marcelocesarreis/safeboat-termica/stl/tampa-traseira.stl

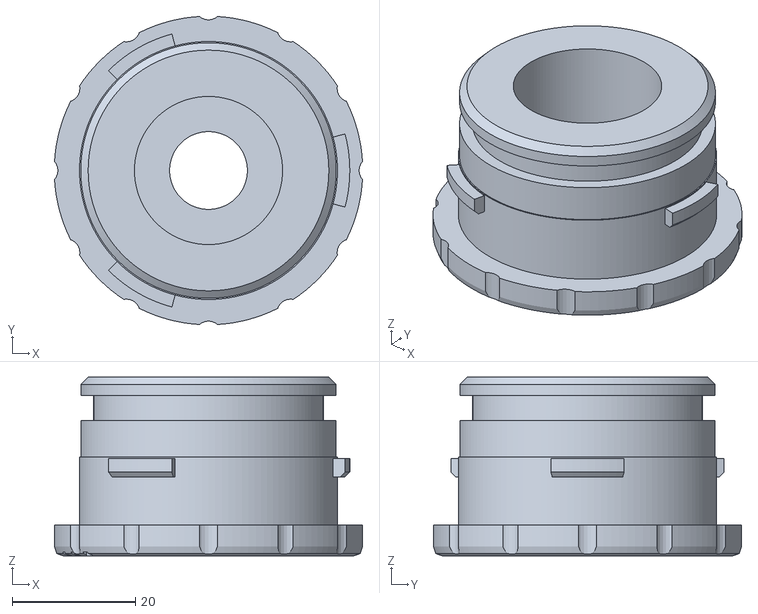
[picture p1: CAD file, 2026-08-03]
stl/tampa-traseira.stl
49.9 x 49.9 x 29.0
