marcelocesarreis/safeboat-termica/stl/gabarito.stl

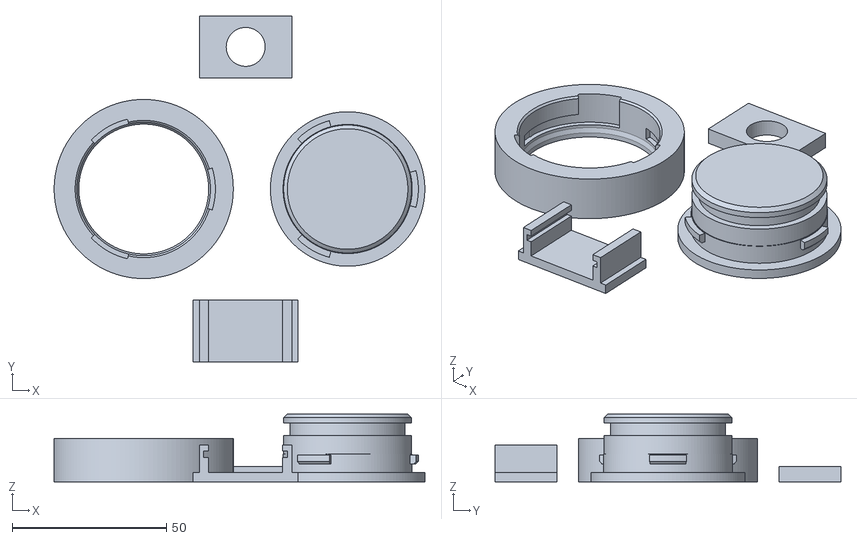
[picture p2: CAD file, 2026-08-03]
stl/gabarito.stl
120.0 x 112.0 x 22.0
