marcelocesarreis/safeboat-termica/stl/corpo.stl

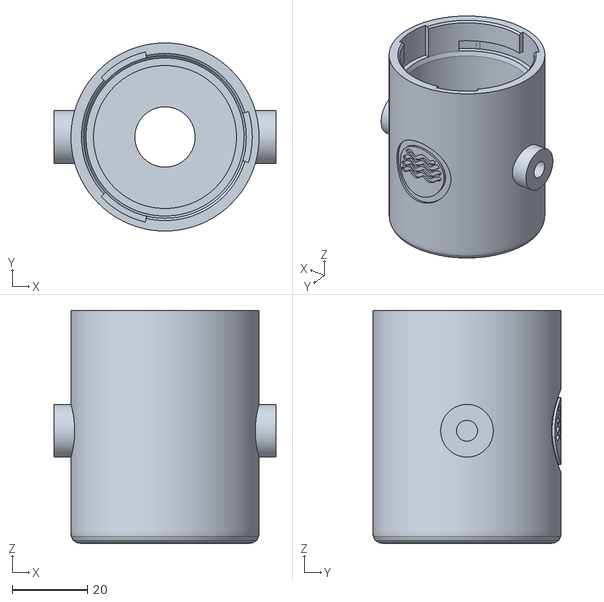
[picture p3: CAD file, 2026-08-03]
stl/corpo.stl
59.0 x 50.0 x 62.0
