marcelocesarreis/safeboat-termica/stl/carrier-interno.stl

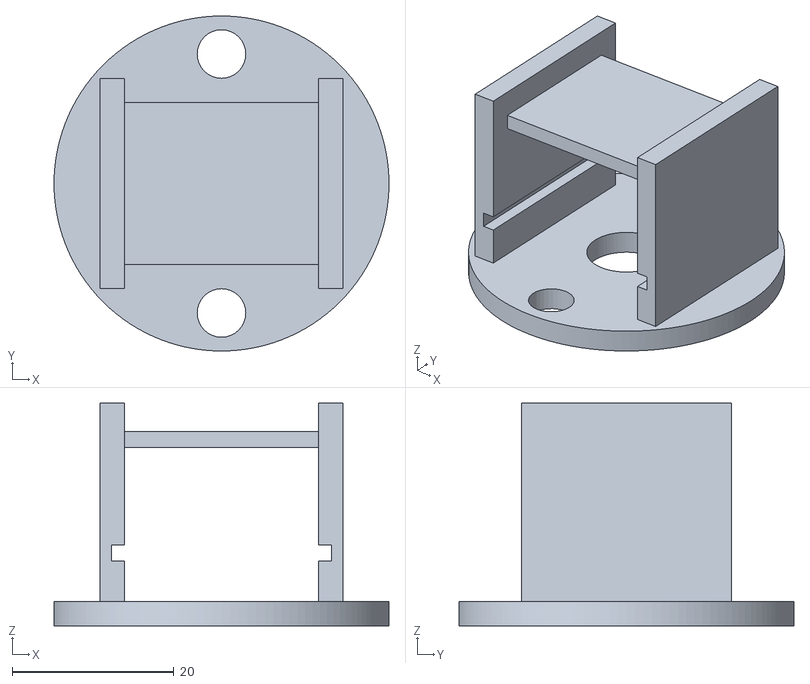
[picture p4: CAD file, 2026-07-28]
stl/carrier-interno.stl
41.4 x 41.4 x 27.5
