marcelocesarreis/safeboat-termica/stl/suporte.stl

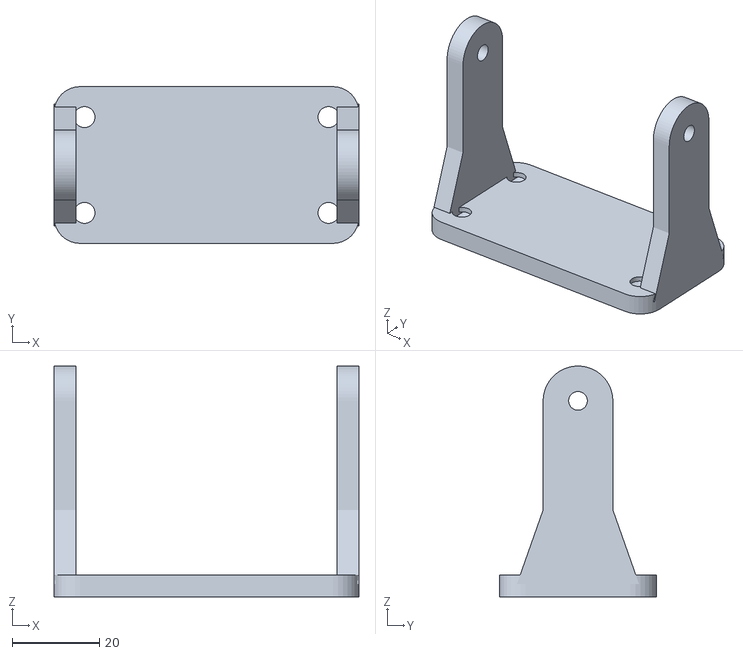
[picture p5: CAD file, 2026-07-16]
stl/suporte.stl
70.0 x 36.0 x 53.0
