marcelocesarreis/safeboat-termica/(commit log)

2026-07-16 SAFEBOAT Termica - pagina do projeto (viewer 3D, rede de analise IA, esquema eletrico)
    [carrier-interno.stl, corpo.stl, suporte.stl, tampa-traseira.stl]
2026-07-17 Adiciona secao de compras: BOM com links de fornecedores (ML/AliExpress)
2026-07-28 Revisao de engenharia rev. B + preparacao para impressao
    - O-ring movido para fora do fim de rosca (vazamento)
    - Rosca com flancos a 45 graus (imprimivel sem suporte)
    - Rebaixo interno para a contraporca do prensa-cabo
    - Disco do carrier maior que o furo frontal (nao montava)
    - Abertura optica conica: sem vinheta nos cantos do FOV
    - Novo gabarito.stl de teste de encaixe (~35 min)
    - Tampa reposicionada no viewer 3D (flange estava enterrado)
    [carrier-interno.stl, corpo.stl, gabarito.stl, tampa-traseira.stl]
2026-08-03 Rev. C: rosca substituida por baioneta de 60 graus
    A rosca impressa da rev. B nao fechou. Causa medida: engajamento de
    0.50 mm contra erro tipico de FDM em furo de 0.20 a 0.45 mm, com crista
    de 1.9 camadas. Era fina demais para o processo.
    Baioneta de quarto de volta:
    - engajamento radial 1.30 mm (2.6x)
    - menor detalhe da peca 1.30 mm (era 0.30 mm)
    - sem geometria helicoidal, faces planas
    - tolera +/- 0.3 mm
    - ressalto de retencao (clique) a 44 de 60 graus
    - O-ring radial com 4.5 mm de furo liso de margem
    Montagem validada por CSG (tools/verify-fit.cjs): entra a 0, gira a 30,
    trava a 60, resiste ao arranque axial e barra insercao desalinhada.
    Ficha de impressao ajustada para a impressora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
    [corpo.stl, gabarito.stl, tampa-traseira.stl]
2026-09-17 Bancada: firmware termica-usb 0.1.2 + visualizador ao vivo por Web Serial
    Primeira luz da camera (MLX90640 sn 18259C6C018B): 10 quadros, 0 perdidos, 4,8 fps.
    - firmware/termica-usb: ESP32-C3 + MLX90640 -> quadros binarios de 1546 B pela USB CDC
    (buffer TX de 4 kB e envio so de quadro inteiro: o padrao de 256 B truncava tudo)
    - bancada.html: Web Serial, imagem interpolada, estatisticas, escala, PNG/CSV,
    simulador e o mesmo detector de anomalias da pagina do projeto
    - serial-parser.js: protocolo unico p/ navegador e Node; trata reset da placa
    [termica-usb.ino]
2026-09-17 Rede sem MQTT: camera analisa a bordo e envia resumos/alertas por HTTPS (receita do VIB)
    - nova secao 'Da camera a nuvem': camera -> hub.safeboat.tech -> API -> app
    - firmware/PLANO-WIFI.md: mensagens (resumo 60 s, alerta com quadro, batimento 600 s),
    etapas 0.2-0.5, licoes herdadas do VIB, pontos em aberto (regime sem RPM, zonas)
    - removidas todas as mencoes a MQTT/broker da pagina, do engine.js e do firmware
    - consumo rotulado como estimativa a medir; alimentacao pelo circuito pos-chave
    [termica-usb.ino]
2026-09-18 Firmware termica 0.2.6: BLE robusto (endereco aleatorio-estatico, derruba central que nao assina, vigia do anuncio)
2026-09-19 Firmware termica 0.2.8 + Bancada: BLE em pedacos numerados e espacados, anuncio so apos o Wi-Fi, endereco por boot, aviso de sensor mudo
